kpayinda/PIM_V02/README.md

# PIM_V02
Flight-like design of PIM. After dev PIM_V01 was proven, this adds an FPGA and optimises size.
