kpayinda/PIM_V02/PIM_V02/PIM_V02_Design_Notes.docx

CHANGES FROM V01:

- I want PGOOD indicators on the payload supplies.
- MCU controls re-enable of eFuse.

eFuse updates:

eFuse: give the MCU full authority (EN + FLT + IMON), and configure latch-off

Your V01 problem is that the TPS259814A's EN/PG/FLT/IMON weren't wired to the MCU. Fix in V02:

- EN/UVLO → MCU GPIO. A high level on EN/UVLO enables the internal FET; held low, the FET is off. This is your on/off and your latch-clear: toggling EN is how the MCU resets a latched fault. Keep the UVLO divider if you want the input-undervoltage trip, and drive EN through it / OR it in — don't lose the 10.8V-ish UVLO by hard-driving the pin. Texas Instruments (https://www.ti.com/lit/ds/symlink/tps25982.pdf)
- FLT → MCU input (EXTI). FLT is an open-drain, active-low fault indicator pulled low when a fault is detected — needs a pull-up, gives you an interrupt on trip. Texas Instruments (https://www.ti.com/lit/ds/symlink/tps25981.pdf)
- PG → MCU input. PG is open-drain, asserted high when the FET is fully on and ready to deliver power. Texas Instruments (https://www.ti.com/lit/ds/symlink/tps25981.pdf)
- IMON → MCU ADC. IMON sources an analog current proportional to FET current; a resistor to GND converts it to a voltage for an ADC, with chopper offset cancellation for accuracy at low currents. Size RIMON so full-scale lands inside your ADC range with headroom. This is what turns "is it tripped" into real current telemetry. Texas Instruments (https://www.ti.com/lit/ds/symlink/tps25980.pdf)
- Configure latch-off, not auto-retry. The rule of thumb is auto-retry for consumer gear, latch-off with PG/FAULT reporting for critical loads — you want the fault to stay off until the MCU decides, so a latched-up payload can't drag the retry loop. This is also exactly your SEL power-cycle mechanism from the radiation framework: IMON→ADC detects the latchup current signature, MCU drops EN, waits, re-asserts. Close that loop deliberately. Ersa Electronics (https://www.ersaelectronics.com/blog/efuse-power-switch-ic)

FPGA:
protocol engine format.

Protocol engine: soft I2C/SPI/UART cores live in the FPGA; MCU commands it over one link ("talk I2C addr 0x40, write these bytes"). More HDL and verification, but arbitrary channel count and offloads the MCU

I2C is open-drain + pull-ups; UART/SPI are push-pull. Leave modest pull-ups (say 4.7–10k) on the muxed lines permanently — a push-pull driver fighting a pull-up just burns a little static current when low, harmless. Don't try to switch pull-ups in/out unless a payload's I2C timing demands a specific value.

I/O bank voltage. iCE40 banks are LVCMOS up to 3.3V (confirm for your exact device — UltraPlus is more restricted). If any payload wants 1.8V, plan level translation or dedicate a bank; you can't retune VCCIO per-pin.

Payload-fault isolation. These pins leave the board to experimental payloads. Series R + TVS on every payload line, and treat a payload short/latch as expected: the FPGA shouldn't be your only protection. Ideally the FPGA (and its I/O bank) sits behind its own monitored/switchable rail so a payload event can be power-cycled without rebooting the whole PIM.

SRAM config in orbit. iCE40 is SRAM-based — it reloads its bitstream every power cycle (MCU over SPI1, per your V01 plan) and its config SRAM can flip under SEU. At ~5 krad TID the dose is likely survivable, but plan config scrubbing: periodic MCU reconfiguration, or CRAM readback-compare, or warmboot on mismatch. Bake this into firmware from the start, not as a retrofit.

MY QUESTIONS:

Inductor placement. moving the inductor to the top side was only meant to help layout better. but if its actually detrimental to this, that sounds like a horrible idea. currently my setup is really good with all power on bottom, as it allows me to put the HK 3v3 and 5v rails underneath where the rest of the circuit on the topside needs them, then all the payload supplies on the far side out of the way. if i had to move all the ICs and caps related to power to the top too, i definitley cannot fit it all. is there a way i can get really flat inductors? its fine if the footprint is bigger, i just need them to have less height.

Also separate issue, in my opinion the power section takes up a lot of room. is there a way i can get the housekeeping supplies to be all merged? i definitley need a stable 5v, 3v3 and 1v2, but it annoys me that i need such a large section for each, especially since they are low power. any solutions? is there a controller than can do all in 1?

I also want advice how to layout the schematic. you have the current layout, with a 'main', CAN and POWER page. but is this the best way? especialy since the 'main' page is full of a jumble of different sections. also with fpga i would need to make a new page to be able to fit more. how do professionals organise their scheamtics? i also dont want too many sheets as that is unnecessarily hard to track then.

## Power Circuit

Inductor selection, updates to not protrude as much.

Aiming for 1.5mm height.

- Replaced all Ls w SRP5015TA-2R2M.
- Fit 0R on all RT (inc freq).

23-SEP-26. KP.

Adding INA current sense to monitor output of PL supplies.

Shunt selection. 10mR 2512

NO NEW PINS – USING SAME I2C PINS AS BEFORE.

Addy: A0 → GND for address 0x40 versus MP28167 is at 0x60. So algs.

\

Changed SWD connector to just pads – so can flash thru SWD but not easy.
