kpayinda/PIM_V02/PIM_V02/PIM_V02.kicad_pcb

## KiCad design PIM_V02/PIM_V02.kicad_pcb (2026-09-28)

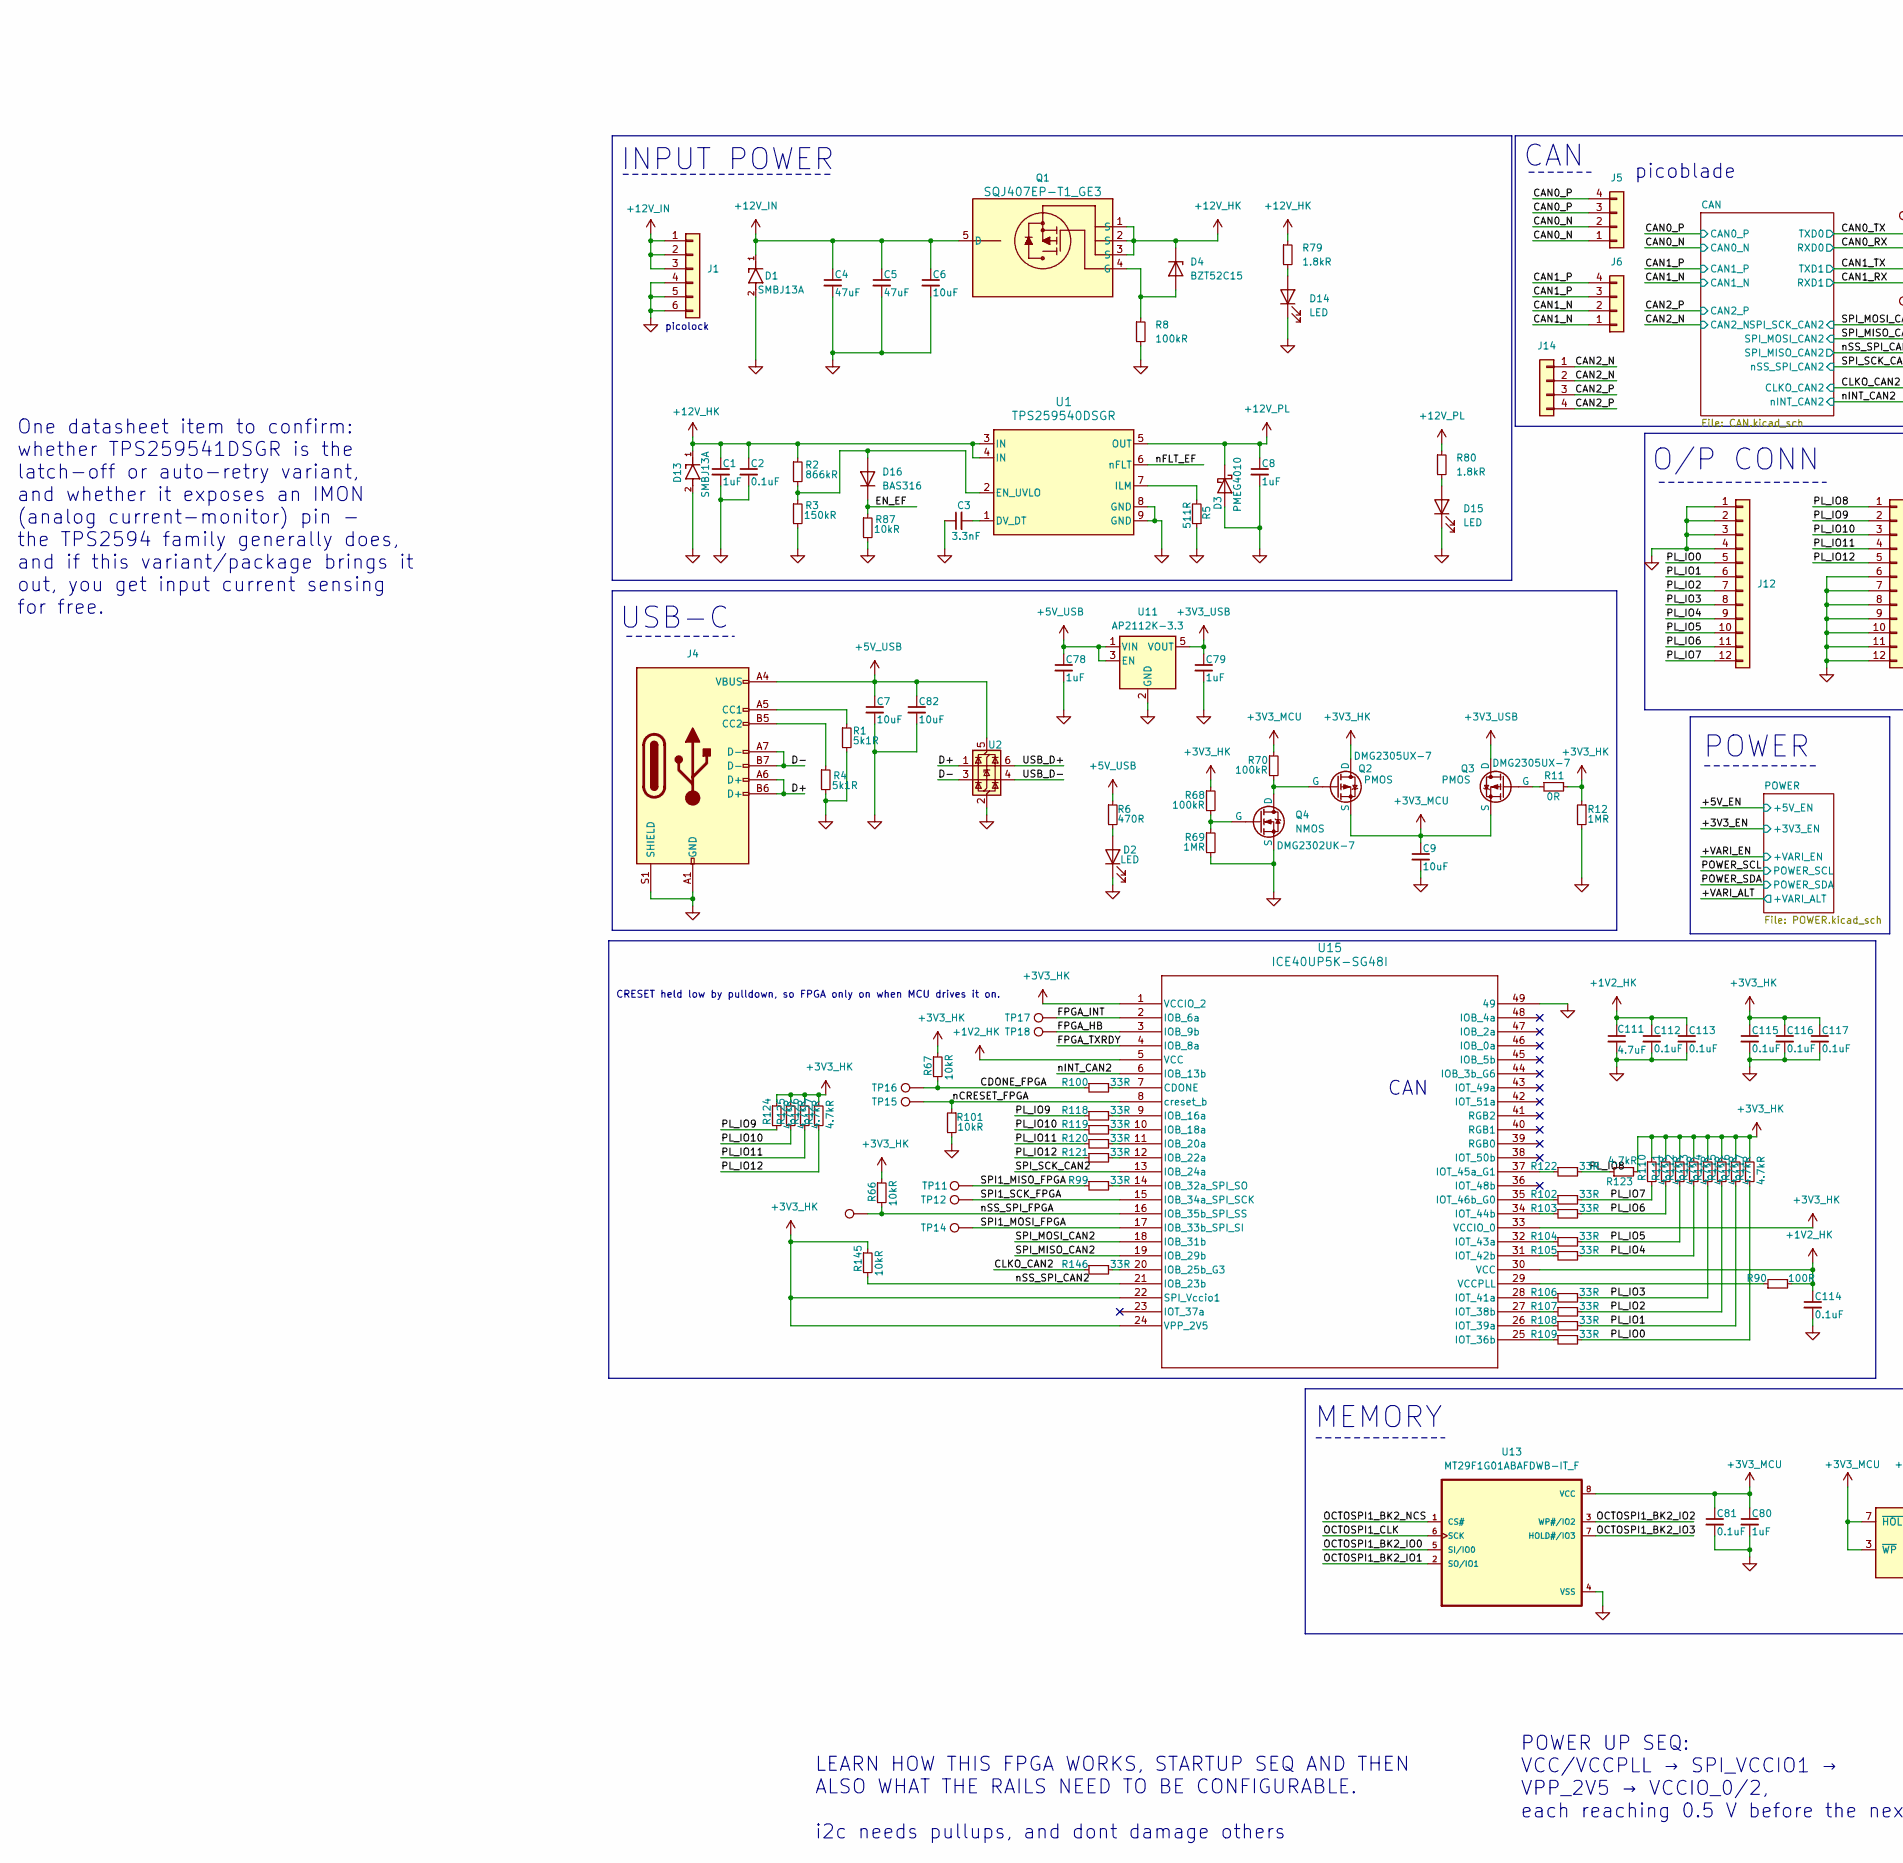
[picture p1: schematic PIM_V02.kicad_sch, PCI-104 Template, part in row 1, column 1]

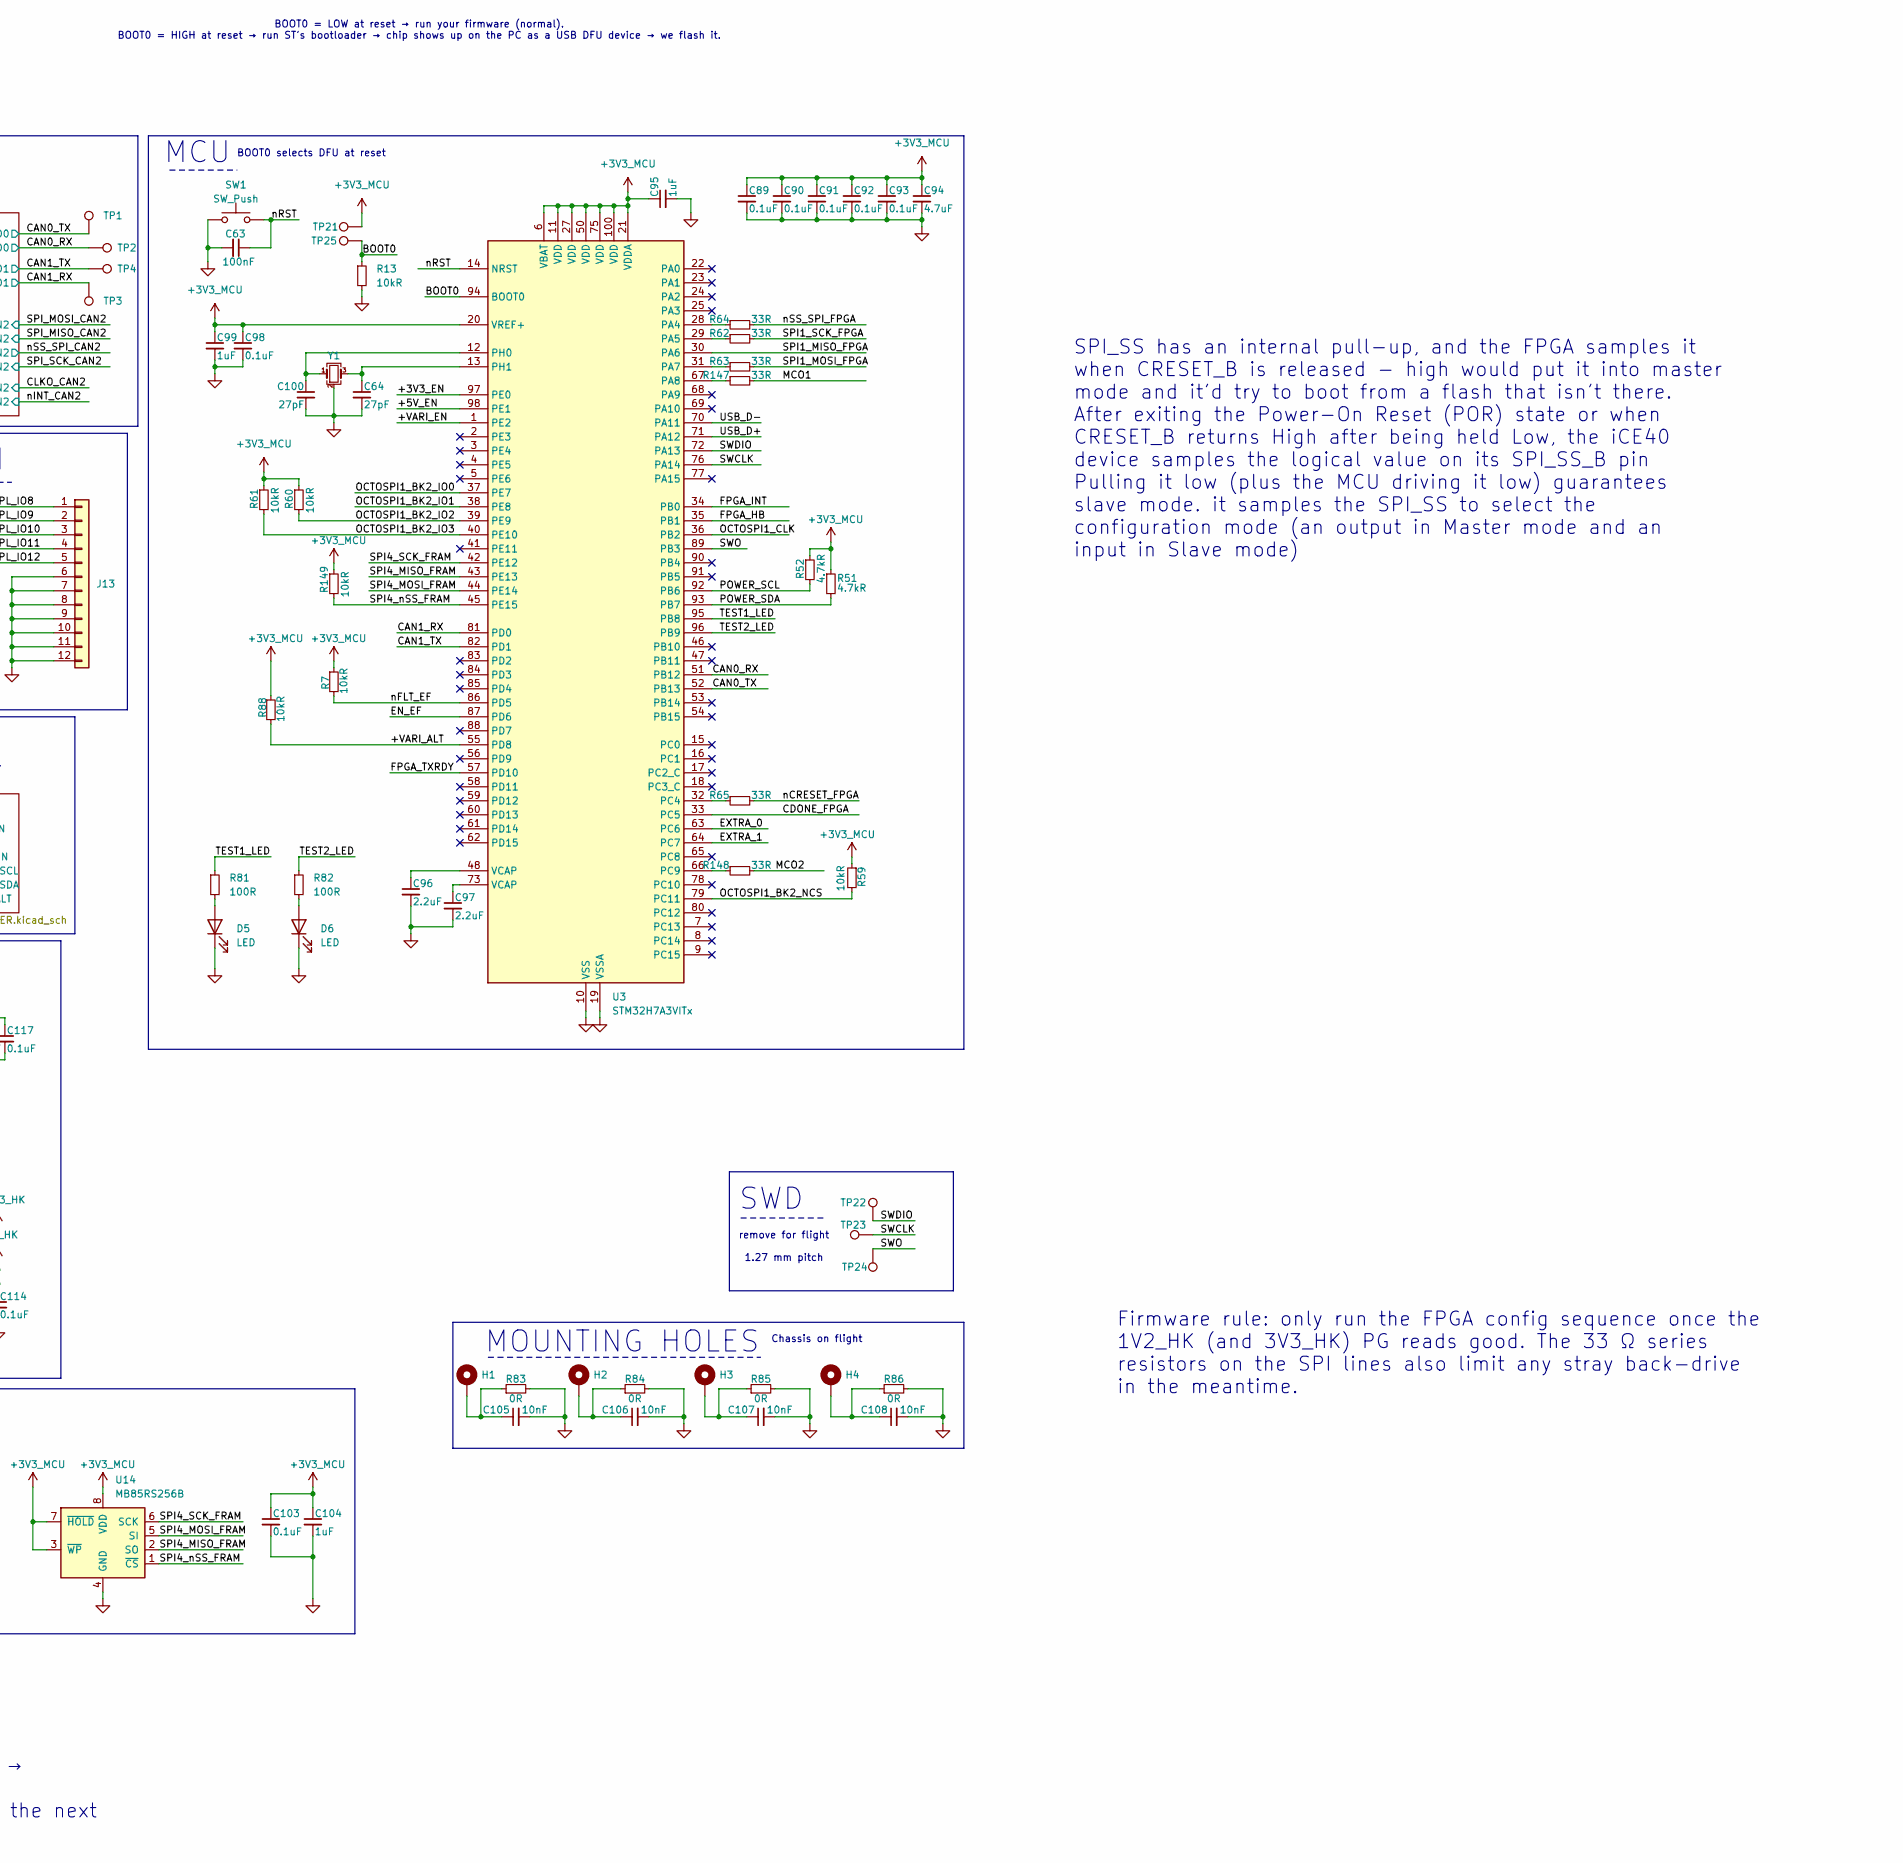
[picture p2: schematic PIM_V02.kicad_sch, PCI-104 Template, part in row 1, column 2]

Parts:
C1, C8, C78, C79, C80, C95, C99, C104: 1uF; C_0603_1608Metric; MPN GCM188R71E105KA64J
C2, C81, C89, C90, C91, C92, C93, C98, C103, C112, C113, C114, C115, C116, C117: 0.1uF; C_0603_1608Metric; MPN GCM188R71H104KA57D
C3: 3.3nF; C_0603_1608Metric; MPN GCM1885C1H332JA16D
C4, C5: 47uF; C_1206_3216Metric; Rating 50V, MLCC; MPN GMC31X5R476M25NT
C6, C7, C9, C82: 10uF; C_0603_1608Metric; MPN GRT188R61E106ME13D
C63: 100nF; C_0603_1608Metric; MPN GCM188R71H104KA57D
C64, C100: 27pF; C_0603_1608Metric; MPN GCM1885C1H270JA16D
C94, C111: 4.7uF; C_0603_1608Metric; MPN MSAST168BB5475MTNA01
C96, C97: 2.2uF; C_0603_1608Metric; MPN GRT188R61E225ME13D
C105, C106, C107, C108: 10nF; C_0603_1608Metric; MPN GCM188R71H103KA37J
D1, D13: SMBJ13A
D2, D5, D6, D14, D15: LED; LED_0603_1608Metric; MPN 150060GS75000
D3: PMEG4010; Nexperia_CFP3_SOD-123W; MPN PMEG4010ER,115
D4: BZT52C15; Nexperia_CFP3_SOD-123W; MPN BZT52C15
D16: BAS316; D_SOD-323
H1, H2, H3, H4: MountingHole_Pad; MountingHole_2.2mm_M2_Pad
J1: Conn_01x06; Molex_Pico-Lock_504050-0691_1x06-1MP_P1.50mm_Horizontal; MPN 5040500691
J4: USB_C_Receptacle_USB2.0_14P; USB_C_Receptacle_GCT_USB4105-xx-A_16P_TopMnt_Horizontal; MPN USB4105-GF-A
J5, J6, J14: Conn_01x04; Molex_PicoBlade_53261-0471_1x04-1MP_P1.25mm_Horizontal; MPN 0532610471
J12, J13: Conn_01x12; 5040501291
Q1: SQJ407EP-T1_GE3; PowerPAK-SO-8L_Option-2_VIS; MPN SQJ407EP-T1_GE3
Q2, Q3: PMOS; SOT-23-3; MPN DMG2305UX-7
Q4: NMOS; SOT-23-3; MPN DMG2302UK-7
R1, R4: 5k1R; R_0603_1608Metric; MPN ERJ-3EKF5101V
R2: 866kR; R_0603_1608Metric; MPN ERJ-3EKF8663V
R3: 150kR; R_0603_1608Metric; MPN ERJ-3EKF1503V
R5: 511R; R_0603_1608Metric; MPN ERJ-3EKF5110V
R6: 470R; R_0603_1608Metric; MPN ERJ-3EKF4700V
R7, R13, R59, R60, R61, R66, R67, R88, R145, R149: 10kR; R_0603_1608Metric; MPN ERJ-3EKF1002V
R8, R68, R70: 100kR; R_0603_1608Metric; MPN ERJ-3EKF1003V
R11, R83, R84, R85, R86: 0R; R_0603_1608Metric; MPN ERJ-3GEY0R00V
R12, R69: 1MR; R_0603_1608Metric; MPN ERJ-3EKF1004V
R51, R52: 4.7kR; R_0603_1608Metric; MPN ERJ-3EKF4701V
R62, R63, R64, R65, R122, R147, R148: 33R; R_0603_1608Metric; MPN ERJ-3EKF33R0V
R79, R80: 1.8kR; R_0603_1608Metric; MPN ERJ-3EKF1801V
R81, R82, R90: 100R; R_0603_1608Metric; MPN ERJ-3EKF1000V
R87, R101: 10kR; R_0603_1608Metric
R99, R100, R102, R103, R104, R105, R106, R107, R108, R109, R118, R119, R120, R121, R146: 33R; R_0402_1005Metric; MPN ERJ-2RKF33R0X
R110, R111, R112, R113, R114, R115, R116, R117, R123, R124, R125, R126, R127: 4.7kR; R_0402_1005Metric; MPN ERJ-2RKF4701X
SW1: SW_Push; SW_SPST_B3U-1000P; MPN B3U-1000P
TP1, TP2, TP3, TP4, TP11, TP12, TP13, TP14, TP15, TP16, TP17, TP18, TP21, TP22, TP23, TP24, TP25: TestPoint; TestPoint_Pad_D1.0mm
U1: TPS259540DSGR; DSG0008A; MPN TPS259540DSGR
U2: USBLC6-2SC6; SOT-23-6; MPN USBLC6-2SC6
U3: STM32H7A3VITx; LQFP-100_14x14mm_P0.5mm; MPN STM32H7A3VIT6
U11: AP2112K-3.3; SOT-23-5; MPN AP2112K-3.3TRG1
U13: MT29F1G01ABAFDWB-IT_F; GD5F1GQ5UEYIGR; PARTREV LTR
U14: MB85RS256B; JEITA_SOIC-8_3.9x4.9mm_P1.27mm; MPN MB85RS256BPNF-G-AMERE2
U15: ICE40UP5K-SG48I; QFN48_L-ASC10_ICE40ULTRAPLUS_MACHXO2_LAT
Y1: Crystal_GND24_Small; Crystal_SMD_Abracon_ABM8G-4Pin_3.2x2.5mm; MPN ABM8G-24.000MHZ-18-D2Y-T3

Connections:
+1V2_HK: C111.1, C112.1, C113.1, C114.1, R90.2, U15.5 (VCC), U15.30 (VCC); also elsewhere on the board
+3V3_HK: C115.1, C116.1, C117.1, Q2.1 (D), R11.2, R12.1, R66.1, R67.1, R68.1, R110.1, R111.1, R112.1, R113.1, R114.1, R115.1, R116.1, R117.1, R123.2, R124.1, R125.1, R126.1, R127.1, R145.1, U15.1 (VCCIO_2), U15.22 (SPI_Vccio1), U15.24 (VPP_2V5), U15.33 (VCCIO_0); also elsewhere on the board
+3V3_MCU: C9.1, C80.1, C81.1, C89.1, C90.1, C91.1, C92.1, C93.1, C94.1, C95.1, C98.1, C99.1, C103.1, C104.1, Q2.3 (S), Q3.3 (S), R7.1, R51.1, R52.1, R59.1, R60.1, R61.1, R70.1, R88.1, R149.1, TP21.1, U3.6 (VBAT), U3.11 (VDD), U3.20 (VREF+), U3.21 (VDDA), U3.27 (VDD), U3.50 (VDD), U3.75 (VDD), U3.100 (VDD), U13.8 (VCC), U14.3 (~WP), U14.7 (~HOLD), U14.8 (VDD); also elsewhere on the board
+3V3_USB: C79.1, Q3.1 (D), U11.5 (VOUT)
+5V_USB: C7.1, C78.1, C82.1, J4.A4 (VBUS), J4.A9 (VBUS), J4.B4 (VBUS), J4.B9 (VBUS), R6.1, U2.5 (VBUS), U11.1 (VIN), U11.3 (EN)
+12V_HK: C1.1, C2.1, D4.1 (K), D13.1, Q1.1 (S), Q1.2 (S), Q1.3 (S), R2.1, R79.1, U1.3 (IN), U1.4 (IN); also elsewhere on the board
+12V_IN: C4.1, C5.1, C6.1, D1.1, J1.1, J1.2, J1.3, Q1.5 (D)
+12V_PL: C8.1, D3.1 (K), R80.1, U1.5 (OUT); also elsewhere on the board
/+3V3_EN: U3.97 (PE0); also elsewhere on the board
/+5V_EN: U3.98 (PE1); also elsewhere on the board
/+VARI_ALT: R88.2, U3.55 (PD8); also elsewhere on the board
/+VARI_EN: U3.1 (PE2); also elsewhere on the board
/BOOT0: R13.1, TP25.1, U3.94 (BOOT0)
/CAN0_N: J5.1, J5.2; also elsewhere on the board
/CAN0_P: J5.3, J5.4; also elsewhere on the board
/CAN0_RX: TP2.1, U3.51 (PB12); also elsewhere on the board
/CAN0_TX: TP1.1, U3.52 (PB13); also elsewhere on the board
/CAN1_N: J6.1, J6.2; also elsewhere on the board
/CAN1_P: J6.3, J6.4; also elsewhere on the board
/CAN1_RX: TP3.1, U3.81 (PD0); also elsewhere on the board
/CAN1_TX: TP4.1, U3.82 (PD1); also elsewhere on the board
/CAN2_N: J14.1, J14.2; also elsewhere on the board
/CAN2_P: J14.3, J14.4; also elsewhere on the board
/CDONE_FPGA: R67.2, R100.1, TP16.1, U3.33 (PC5)
/CLKO_CAN2: R146.1; also elsewhere on the board
/D+: J4.A6 (D+), J4.B6 (D+), U2.1 (I/O1)
/D-: J4.A7 (D-), J4.B7 (D-), U2.3 (I/O2)
/EN_EF: D16.1 (K), R87.1, U3.87 (PD6)
/EXTRA_0: U3.63 (PC6)
/EXTRA_1: U3.64 (PC7)
/FPGA_HB: TP18.1, U3.35 (PB1), U15.3 (IOB_9b)
/FPGA_INT: TP17.1, U3.34 (PB0), U15.2 (IOB_6a)
/FPGA_TXRDY: U3.57 (PD10), U15.4 (IOB_8a)
/MCO1: R147.2
/MCO2: R148.2
/OCTOSPI1_BK2_IO0: U3.37 (PE7), U13.5 (SI/IO0)
/OCTOSPI1_BK2_IO1: U3.38 (PE8), U13.2 (SO/IO1)
/OCTOSPI1_BK2_IO2: R60.2, U3.39 (PE9), U13.3 (WP#/IO2)
/OCTOSPI1_BK2_IO3: R61.2, U3.40 (PE10), U13.7 (HOLD#/IO3)
/OCTOSPI1_BK2_NCS: R59.2, U3.79 (PC11), U13.1 (CS#)
/OCTOSPI1_CLK: U3.36 (PB2), U13.6 (SCK)
/PL_IO0: J12.5, R109.2, R117.2
/PL_IO1: J12.6, R108.2, R116.2
/PL_IO2: J12.7, R107.2, R115.2
/PL_IO3: J12.8, R106.2, R114.2
/PL_IO4: J12.9, R105.2, R113.2
/PL_IO5: J12.10, R104.2, R112.2
/PL_IO6: J12.11, R103.2, R111.2
/PL_IO7: J12.12, R102.2, R110.2
/PL_IO8: J13.1, R122.2, R123.1
/PL_IO9: J13.2, R118.1, R124.2
/PL_IO10: J13.3, R119.1, R125.2
/PL_IO11: J13.4, R120.1, R126.2
/PL_IO12: J13.5, R121.1, R127.2
/POWER_SCL: R52.2, U3.92 (PB6); also elsewhere on the board
/POWER_SDA: R51.2, U3.93 (PB7); also elsewhere on the board
/SPI1_MISO_FPGA: R99.1, TP11.1, U3.30 (PA6)
/SPI1_MOSI_FPGA: R63.2, TP14.1, U15.17 (IOB_33b_SPI_SI)
/SPI1_SCK_FPGA: R62.2, TP12.1, U15.15 (IOB_34a_SPI_SCK)
/SPI4_MISO_FRAM: U3.43 (PE13), U14.2 (SO)
/SPI4_MOSI_FRAM: U3.44 (PE14), U14.5 (SI)
/SPI4_SCK_FRAM: U3.42 (PE12), U14.6 (SCK)
/SPI4_nSS_FRAM: R149.2, U3.45 (PE15), U14.1 (~CS)
/SPI_MISO_CAN2: U15.19 (IOB_29b); also elsewhere on the board
/SPI_MOSI_CAN2: U15.18 (IOB_31b); also elsewhere on the board
/SPI_SCK_CAN2: U15.13 (IOB_24a); also elsewhere on the board
/SWCLK: TP23.1, U3.76 (PA14)
/SWDIO: TP22.1, U3.72 (PA13)
/SWO: TP24.1, U3.89 (PB3)
/TEST1_LED: R81.1, U3.95 (PB8)
/TEST2_LED: R82.1, U3.96 (PB9)
/USB_D+: U2.6 (I/O1), U3.71 (PA12)
/USB_D-: U2.4 (I/O2), U3.70 (PA11)
/nCRESET_FPGA: R65.2, R101.1, TP15.1, U15.8 (creset_b)
/nFLT_EF: R7.2, U1.6 (nFLT), U3.86 (PD5)
/nINT_CAN2: U15.6 (IOB_13b); also elsewhere on the board
/nRST: C63.1, SW1.2, U3.14 (NRST)
/nSS_SPI_CAN2: R145.2, U15.21 (IOB_23b); also elsewhere on the board
/nSS_SPI_FPGA: R64.2, R66.2, TP13.1, U15.16 (IOB_35b_SPI_SS)
GND: C1.2, C2.2, C3.1, C4.2, C5.2, C6.2, C7.2, C8.2, C9.2, C63.2, C64.2, C78.2, C79.2, C80.2, C81.2, C82.2, C89.2, C90.2, C91.2, C92.2, C93.2, C94.2, C95.2, C96.2, C97.2, C98.2, C99.2, C100.2, C103.2, C104.2, C105.2, C106.2, C107.2, C108.2, C111.2, C112.2, C113.2, C114.2, C115.2, C116.2, C117.2, D1.2, D2.1 (K), D3.2 (A), D5.1 (K), D6.1 (K), D13.2, D14.1 (K), D15.1 (K), J1.4, J1.5, J1.6, J4.A1 (GND), J4.A12 (GND), J4.B1 (GND), J4.B12 (GND), J4.S1 (SHIELD), J12.1, J12.2, J12.3, J12.4, J13.6, J13.7, J13.8, J13.9, J13.10, J13.11, J13.12, Q4.3 (S), R1.2, R3.2, R4.2, R5.1, R8.2, R12.2, R13.2, R69.2, R83.2, R84.2, R85.2, R86.2, R87.2, R101.2, SW1.1, U1.8 (GND), U1.9 (GND), U2.2 (GND), U3.10 (VSS), U3.19 (VSSA), U3.26 (VSS), U3.49 (VSS), U3.74 (VSS), U3.99 (VSS), U11.2 (GND), U13.4 (VSS), U14.4 (GND), U15.49, Y1.2 (G), Y1.4 (G); also elsewhere on the board
unnamed: C96.1, U3.48 (VCAP)
unnamed: C97.1, U3.73 (VCAP)
unnamed: C105.1, H1.1, R83.1
unnamed: C106.1, H2.1, R84.1
unnamed: C107.1, H3.1, R85.1
unnamed: C108.1, H4.1, R86.1
unnamed: D2.2 (A), R6.2
unnamed: D4.2 (A), Q1.4 (G), R8.1
unnamed: D5.2 (A), R81.2
unnamed: D6.2 (A), R82.2
unnamed: D14.2 (A), R79.2
unnamed: D15.2 (A), R80.2
unnamed: D16.2 (A), R2.2, R3.1, U1.2 (EN_UVLO)
unnamed: J4.A5 (CC1), R1.1
unnamed: J4.B5 (CC2), R4.1
unnamed: Q2.2 (G), Q4.1 (D), R70.2
unnamed: Q3.2 (G), R11.1
unnamed: Q4.2 (G), R68.2, R69.1
unnamed: C3.2, U1.1 (DV_DT)
unnamed: R5.2, U1.7 (ILM)
unnamed: R64.1, U3.28 (PA4)
unnamed: R62.1, U3.29 (PA5)
unnamed: R63.1, U3.31 (PA7)
unnamed: R147.1, U3.67 (PA8)
unnamed: R65.1, U3.32 (PC4)
unnamed: R148.1, U3.66 (PC9)
unnamed: C100.1, U3.12 (PH0), Y1.1
unnamed: C64.1, U3.13 (PH1), Y1.3
unnamed: R100.2, U15.7 (CDONE)
unnamed: R118.2, U15.9 (IOB_16a)
unnamed: R119.2, U15.10 (IOB_18a)
unnamed: R120.2, U15.11 (IOB_20a)
unnamed: R121.2, U15.12 (IOB_22a)
unnamed: R146.2, U15.20 (IOB_25b_G3)
unnamed: R99.2, U15.14 (IOB_32a_SPI_SO)
unnamed: R109.1, U15.25 (IOT_36b)
unnamed: R107.1, U15.27 (IOT_38b)
unnamed: R108.1, U15.26 (IOT_39a)
unnamed: R106.1, U15.28 (IOT_41a)
unnamed: R105.1, U15.31 (IOT_42b)
unnamed: R104.1, U15.32 (IOT_43a)
unnamed: R103.1, U15.34 (IOT_44b)
unnamed: R122.1, U15.37 (IOT_45a_G1)
unnamed: R102.1, U15.35 (IOT_46b_G0)
unnamed: R90.1, U15.29 (VCCPLL)

Notes on the sheet:
BOOT0 selects DFU at reset
LEARN HOW THIS FPGA WORKS, STARTUP SEQ AND THEN ALSO WHAT THE RAILS NEED TO BE CONFIGURABLE. i2c needs pullups, and dont damage others
picoblade
POWER UP SEQ: VCC/VCCPLL → SPI_VCCIO1 → VPP_2V5 → VCCIO_0/2, each reaching 0.5 V before the next
BOOT0 = LOW at reset → run your firmware (normal). BOOT0 = HIGH at reset → run ST's bootloader → chip shows up on the PC as a USB DFU device → we flash it.
remove for flight 1.27 mm pitch
SPI_SS has an internal pull-up, and the FPGA samples it when CRESET_B is released - high would put it into master mode and it'd try to boot from a flash that isn't there. After exiting the Power-On Reset (POR) state or when CRESET_B returns High after being held Low, the iCE40 device samples the lo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
CRESET held low by pulldown, so FPGA only on when MCU drives it on.
USB-C
Chassis on flight
POWER
MCU
One datasheet item to confirm: whether TPS259541DSGR is the latch-off or auto-retry variant, and whether it exposes an IMON (analog current-monitor) pin - the TPS2594 family generally does, and if this variant/package brings it out, you get input current sensing for free.
picolock
O/P CONN
Firmware rule: only run the FPGA config sequence once the 1V2_HK (and 3V3_HK) PG reads good. The 33 Ω series resistors on the SPI lines also limit any stray back-drive in the meantime.
INPUT POWER
CAN
MEMORY
MOUNTING HOLES
SWD

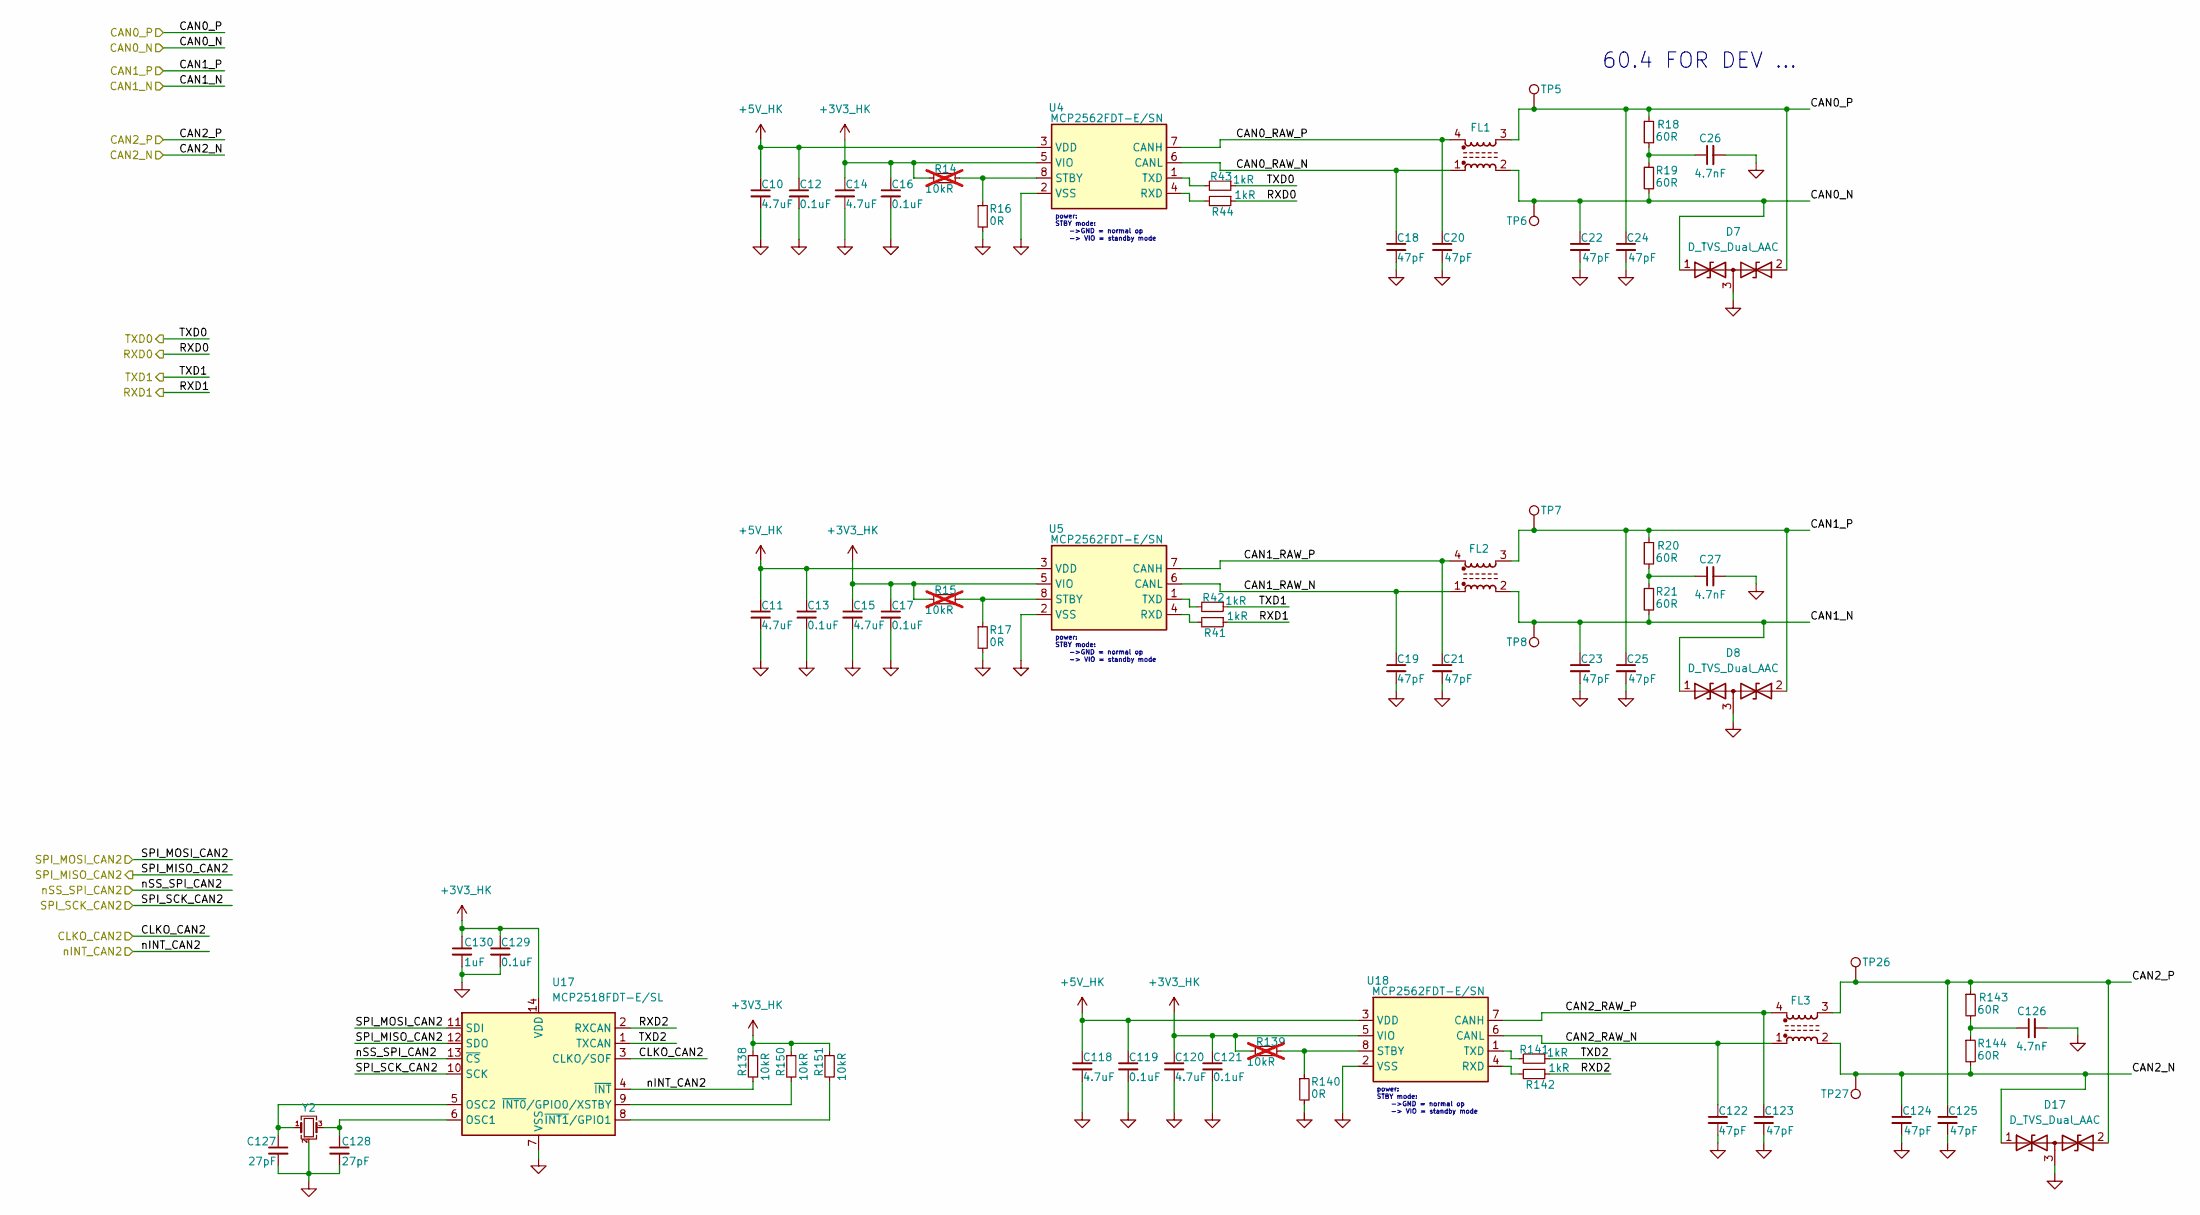
[picture p3: schematic CAN.kicad_sch]

Parts:
C10, C11, C14, C15, C118, C120: 4.7uF; C_0603_1608Metric; MPN MSAST168BB5475MTNA01
C12, C13, C16, C17, C119, C121, C129: 0.1uF; C_0603_1608Metric; MPN GCM188R71H104KA57D
C18, C19, C20, C21, C22, C23, C24, C25, C122, C123, C124, C125: 47pF; C_0603_1608Metric; MPN GCM1885C1H470JA16D
C26, C27, C126: 4.7nF; C_0603_1608Metric; MPN GCM1885C1H472GA16D
C127, C128: 27pF; C_0603_1608Metric; MPN GCM1885C1H270JA16D
C130: 1uF; C_0603_1608Metric; MPN GCM188R71E105KA64J
D7, D8, D17: D_TVS_Dual_AAC; SOT-23-3; MPN ESD16VHYFHT116
FL1, FL2, FL3: Choke_CommonMode_FerriteCore_1243; L_CommonModeChoke_Coilcraft_1812CAN; MPN ACT45B-101-2P-TL003
R14, R15, R139: 10kR; R_0603_1608Metric; MPN ERJ-3EKF1002V; not fitted
R16, R17, R140: 0R; R_0603_1608Metric; MPN ERJ-3GEY0R00V
R18, R19, R20, R21, R143, R144: 60R; R_0603_1608Metric; MPN ERJ-3EKF60R4V
R41, R42, R43, R44, R141, R142: 1kR; R_0603_1608Metric; MPN ERJ-3EKF1001V
R138, R150, R151: 10kR; R_0603_1608Metric; MPN ERJ-3EKF1002V
TP5, TP6, TP7, TP8, TP26, TP27: TestPoint; TestPoint_Pad_D1.0mm
U4, U5, U18: MCP2562FDT-E/SN; SOIC-8_3.9x4.9mm_P1.27mm; MPN MCP2562FDT-E/SN
U17: MCP2518FDT-E/SL; SOIC-14_3.9x8.7mm_P1.27mm
Y2: Crystal_GND24_Small; Crystal_SMD_Abracon_ABM8G-4Pin_3.2x2.5mm; MPN ABM8G-40.000MHZ-18-D2Y-T

Connections:
+3V3_HK: C14.1, C15.1, C16.1, C17.1, C120.1, C121.1, C129.1, C130.1, R14.2, R15.2, R138.1, R139.2, R150.1, R151.1, U4.5 (VIO), U5.5 (VIO), U17.14 (VDD), U18.5 (VIO); also elsewhere on the board
+5V_HK: C10.1, C11.1, C12.1, C13.1, C118.1, C119.1, U4.3 (VDD), U5.3 (VDD), U18.3 (VDD); also elsewhere on the board
/CAN0_N: C22.1, D7.1 (A1), FL1.2, R19.2, TP6.1; also elsewhere on the board
/CAN0_P: C24.1, D7.2 (A2), FL1.3, R18.1, TP5.1; also elsewhere on the board
/CAN0_RX: R44.1; also elsewhere on the board
/CAN0_TX: R43.1; also elsewhere on the board
/CAN1_N: C23.1, D8.1 (A1), FL2.2, R21.2, TP8.1; also elsewhere on the board
/CAN1_P: C25.1, D8.2 (A2), FL2.3, R20.1, TP7.1; also elsewhere on the board
/CAN1_RX: R41.1; also elsewhere on the board
/CAN1_TX: R42.1; also elsewhere on the board
/CAN2_N: C124.1, D17.1 (A1), FL3.2, R144.2, TP27.1; also elsewhere on the board
/CAN2_P: C125.1, D17.2 (A2), FL3.3, R143.1, TP26.1; also elsewhere on the board
/CAN/CAN0_RAW_N: C18.1, FL1.1, U4.6 (CANL)
/CAN/CAN0_RAW_P: C20.1, FL1.4, U4.7 (CANH)
/CAN/CAN1_RAW_N: C19.1, FL2.1, U5.6 (CANL)
/CAN/CAN1_RAW_P: C21.1, FL2.4, U5.7 (CANH)
/CAN/CAN2_RAW_N: C122.1, FL3.1, U18.6 (CANL)
/CAN/CAN2_RAW_P: C123.1, FL3.4, U18.7 (CANH)
/CAN/RXD2: R142.1, U17.2 (RXCAN)
/CAN/TXD2: R141.1, U17.1 (TXCAN)
/CLKO_CAN2: U17.3 (CLKO/SOF); also elsewhere on the board
/SPI_MISO_CAN2: U17.11 (SDI); also elsewhere on the board
/SPI_MOSI_CAN2: U17.10 (SCK); also elsewhere on the board
/SPI_SCK_CAN2: U17.13 (~CS); also elsewhere on the board
/nINT_CAN2: R138.2, U17.4 (~INT); also elsewhere on the board
/nSS_SPI_CAN2: U17.12 (SDO); also elsewhere on the board
GND: C10.2, C11.2, C12.2, C13.2, C14.2, C15.2, C16.2, C17.2, C18.2, C19.2, C20.2, C21.2, C22.2, C23.2, C24.2, C25.2, C26.2, C27.2, C118.2, C119.2, C120.2, C121.2, C122.2, C123.2, C124.2, C125.2, C126.2, C127.2, C128.2, C129.2, C130.2, D7.3 (common), D8.3 (common), D17.3 (common), R16.2, R17.2, R140.2, U4.2 (VSS), U5.2 (VSS), U17.7 (VSS), U17.15 (VSS), U18.2 (VSS), Y2.2 (G), Y2.4 (G); also elsewhere on the board
unnamed: C26.1, R18.2, R19.1
unnamed: C27.1, R20.2, R21.1
unnamed: C126.1, R143.2, R144.1
unnamed: R44.2, U4.4 (RXD)
unnamed: R14.1, R16.1, U4.8 (STBY)
unnamed: R43.2, U4.1 (TXD)
unnamed: R41.2, U5.4 (RXD)
unnamed: R15.1, R17.1, U5.8 (STBY)
unnamed: R42.2, U5.1 (TXD)
unnamed: C128.1, U17.6 (OSC1), Y2.3
unnamed: C127.1, U17.5 (OSC2), Y2.1
unnamed: R150.2, U17.9 (~INT0/GPIO0/XSTBY)
unnamed: R151.2, U17.8 (~INT1/GPIO1)
unnamed: R142.2, U18.4 (RXD)
unnamed: R139.1, R140.1, U18.8 (STBY)
unnamed: R141.2, U18.1 (TXD)

Notes on the sheet:
60.4 FOR DEV ...
power: STBY mode: ->GND = normal op -> VIO = standby mode
