kpayinda/PIM_V02/PIM_V02/PIM_V02.kicad_pcb

## KiCad design PIM_V02/PIM_V02.kicad_pcb (continued)

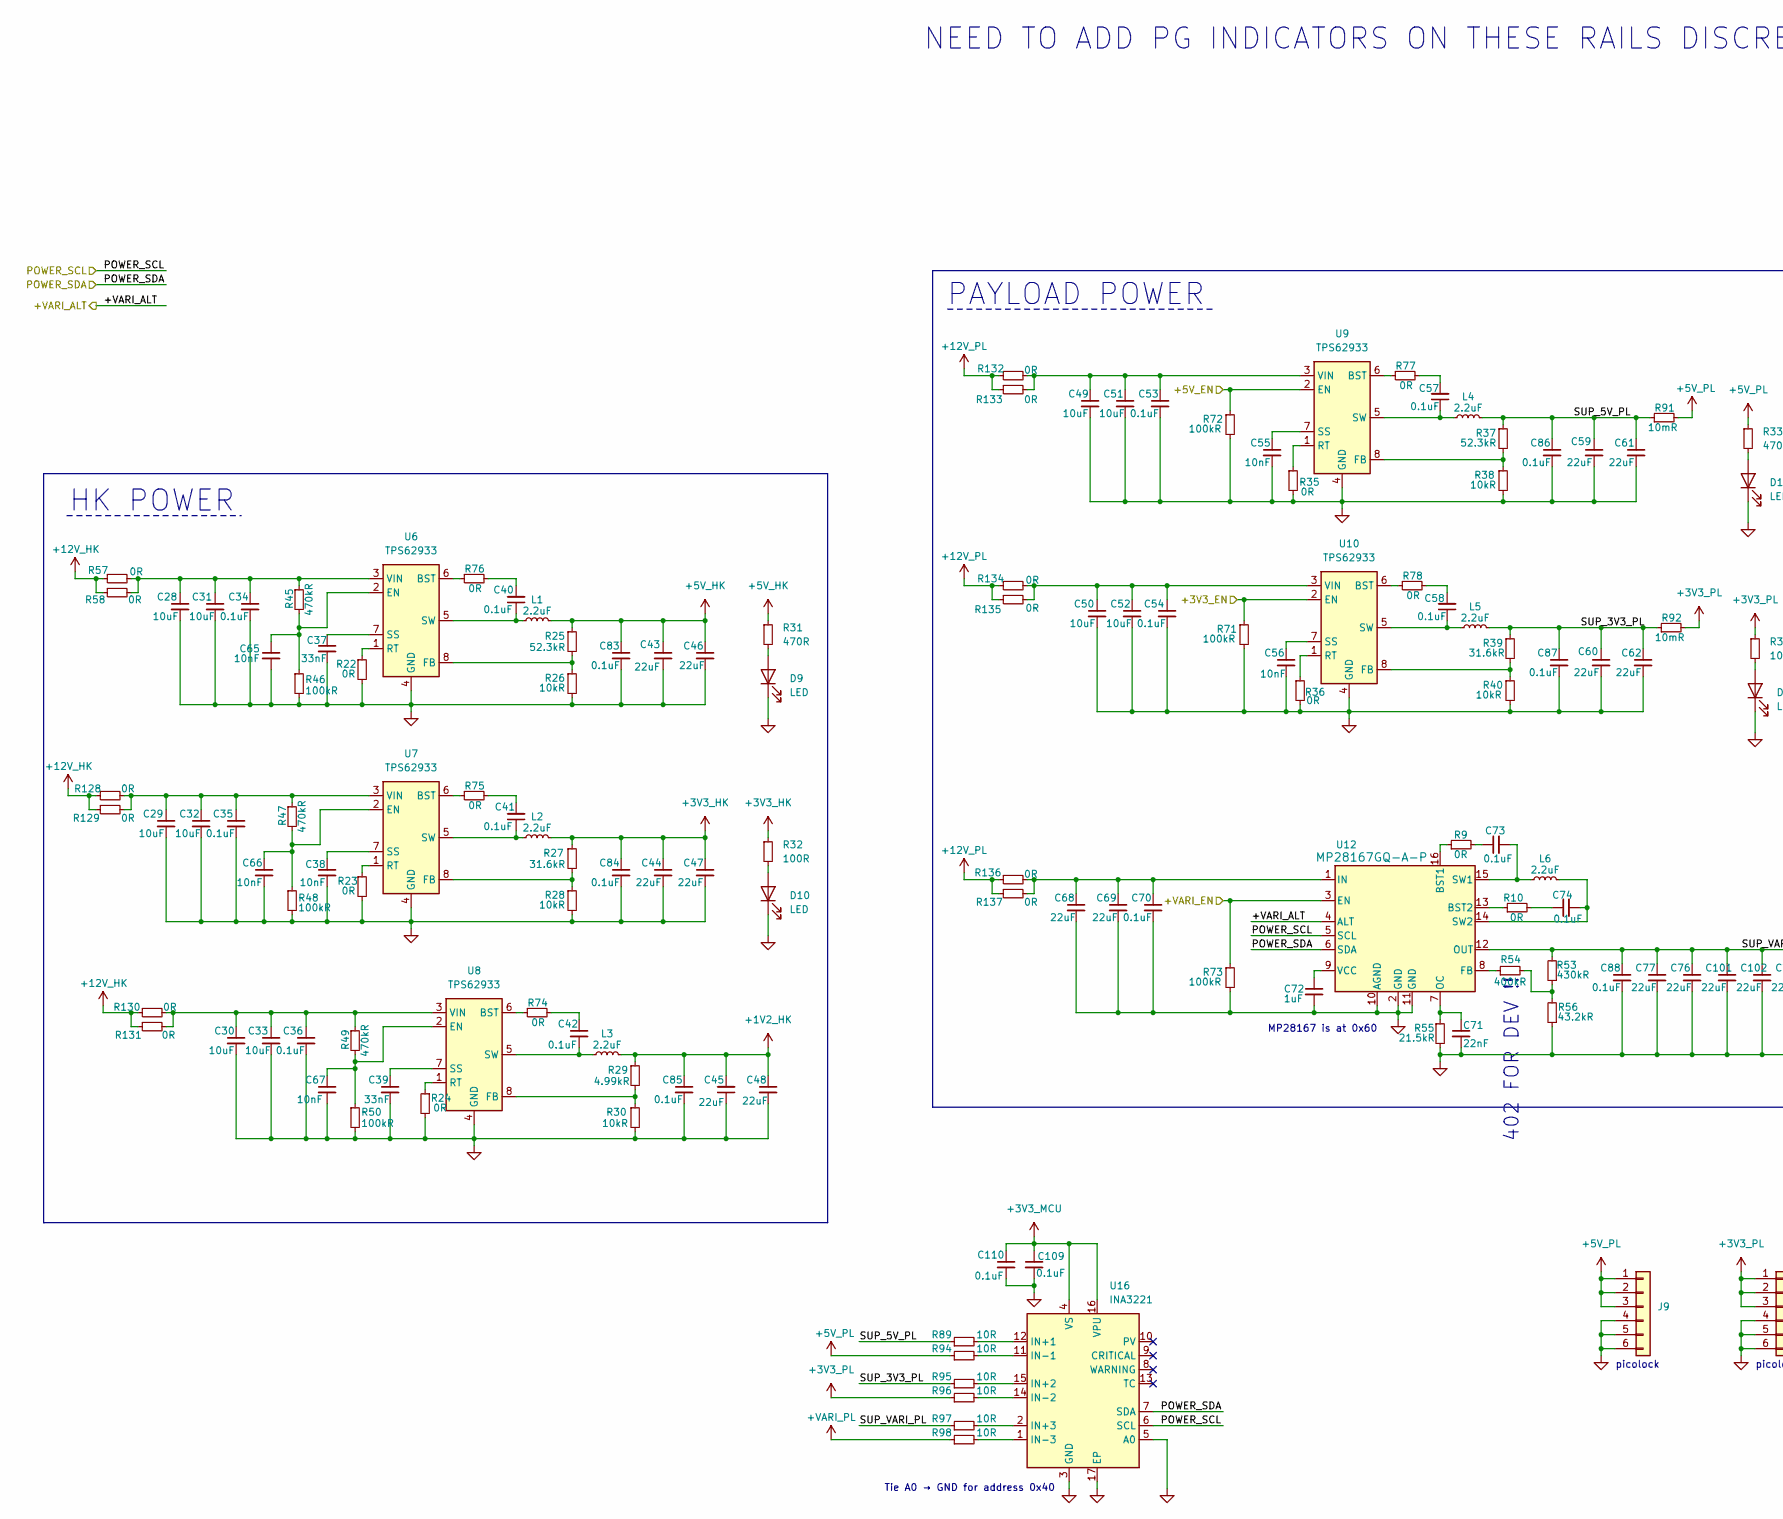
[picture p4: schematic POWER.kicad_sch, part in row 1, column 1]

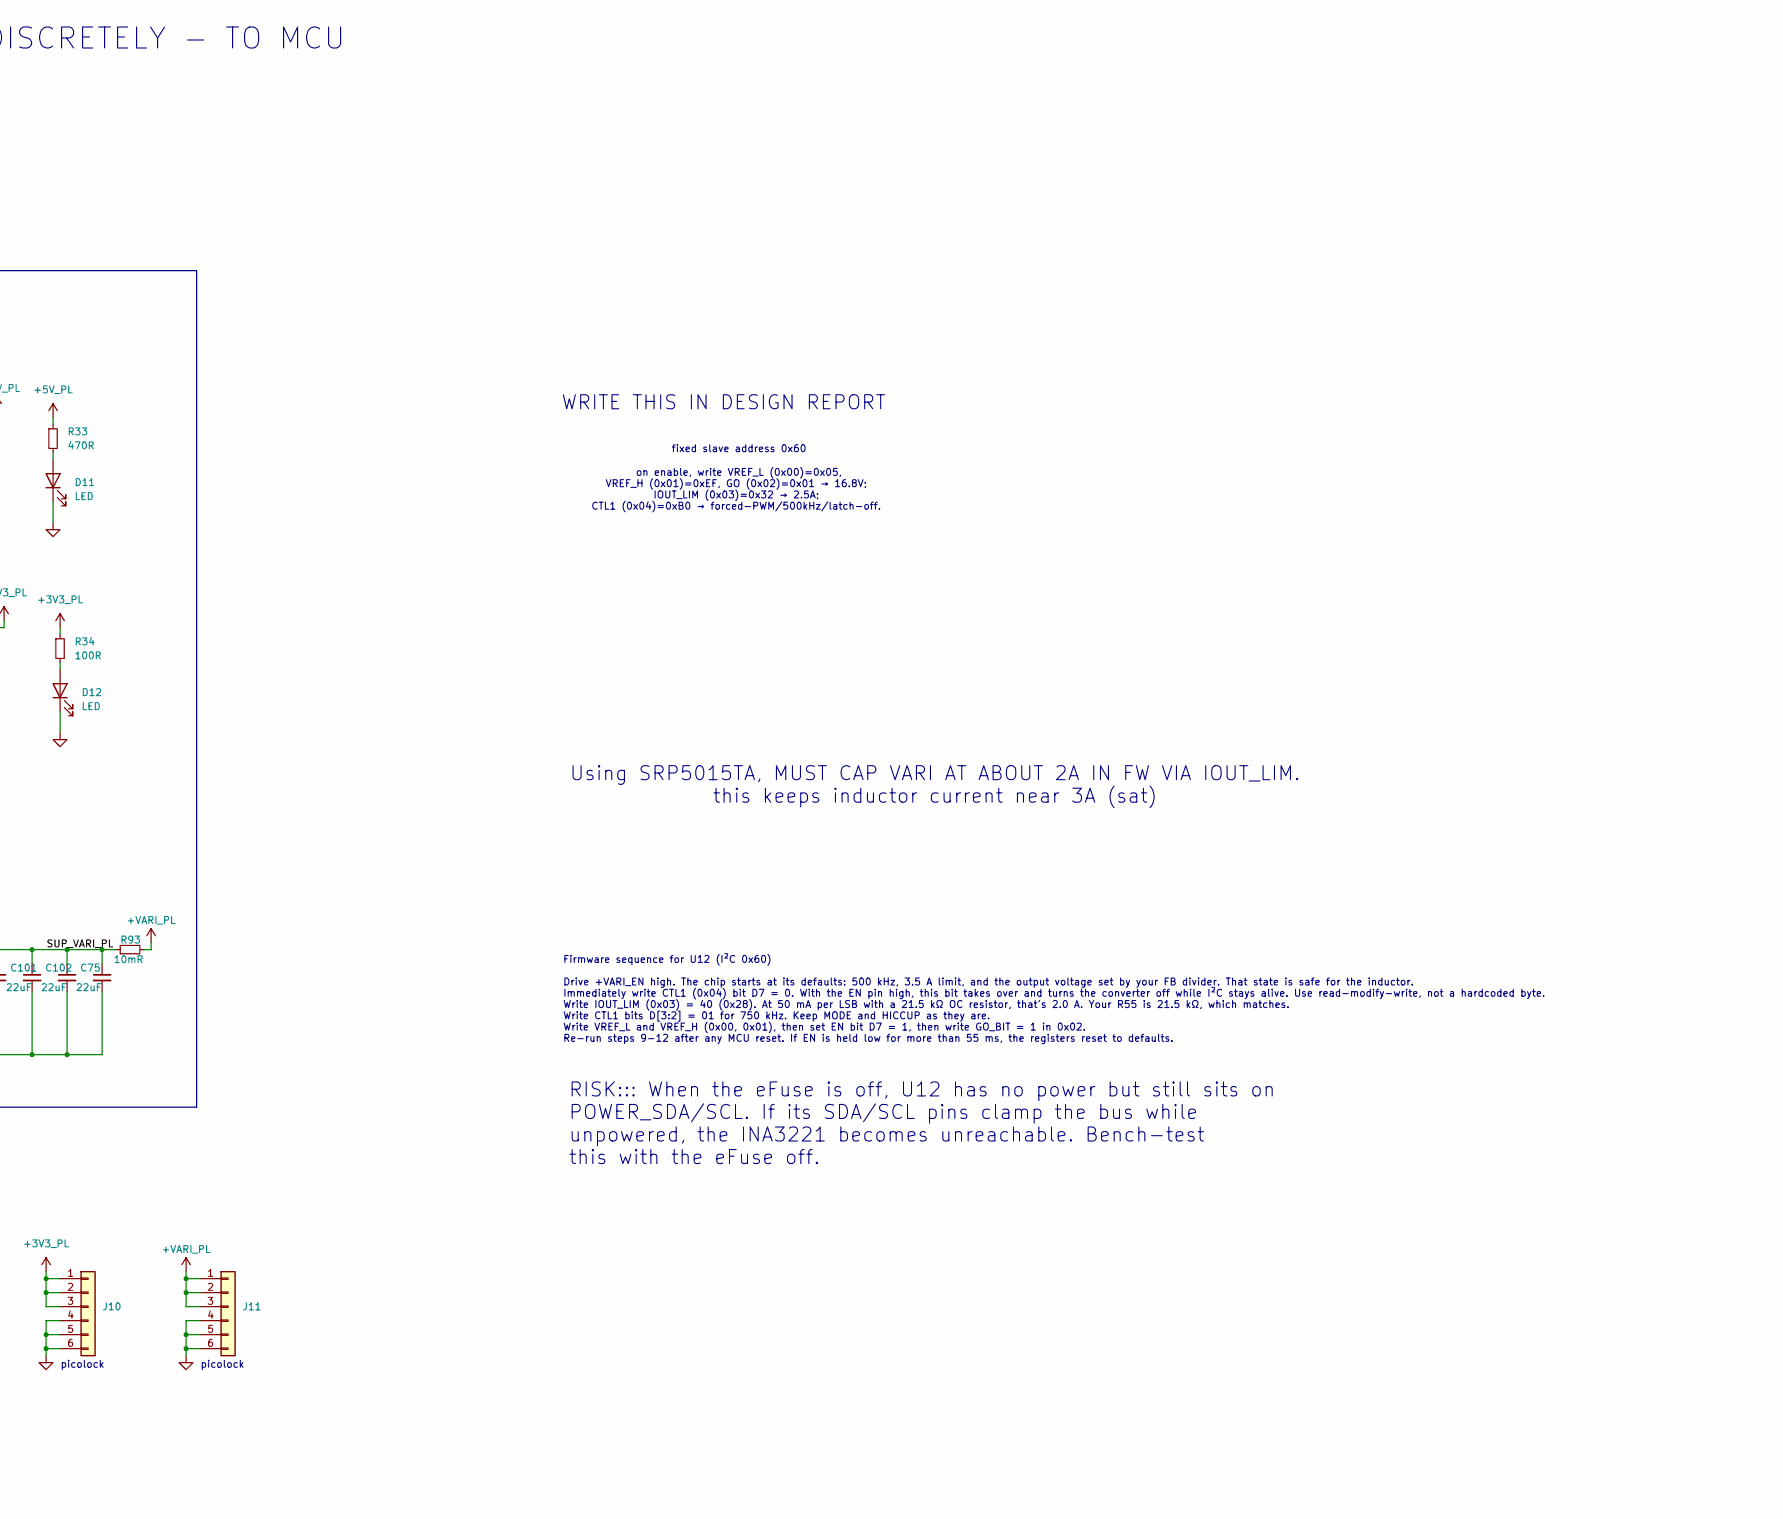
[picture p5: schematic POWER.kicad_sch, part in row 1, column 2]

Parts:
C28, C29, C30, C31, C32, C33, C49, C50, C51, C52: 10uF; C_0603_1608Metric; MPN GRT188R61E106ME13D
C34, C35, C36, C40, C41, C42, C53, C54, C57, C58, C70, C73, C74, C83, C84, C85, C86, C87, C88, C109, C110: 0.1uF; C_0603_1608Metric; MPN GCM188R71H104KA57D
C37, C39: 33nF; C_0603_1608Metric; MPN AC0603KRX7R9BB333
C38, C55, C56, C65, C66, C67: 10nF; C_0603_1608Metric; MPN GCM188R71H103KA37J
C43, C44, C45, C46, C47, C48, C59, C60, C61, C62: 22uF; C_0603_1608Metric; MPN GRT188R61A226ME13D
C68, C69, C75, C76, C77, C101, C102: 22uF; C_0805_2012Metric; MPN GRM21BR61E226ME44L
C71: 22nF; C_0603_1608Metric; MPN GCM188R71H223KA37J
C72: 1uF; C_0603_1608Metric; MPN GCM188R71E105KA64J
D9, D10, D11, D12: LED; LED_0603_1608Metric; MPN 150060GS75000
J9, J10, J11: Conn_01x06; Molex_Pico-Lock_504050-0691_1x06-1MP_P1.50mm_Horizontal; MPN 5040500691
L1, L2, L3, L4, L5, L6: 2.2uF; SRP5015TA-2R2M; MPN SRP5015TA-2R2M
R9, R10, R22, R23, R24, R35, R36, R57, R58, R74, R75, R76, R77, R78, R128, R129, R130, R131, R132, R133, R134, R135, R136, R137: 0R; R_0603_1608Metric; MPN ERJ-3GEY0R00V
R25, R37: 52.3kR; R_0603_1608Metric; MPN ERJ-3EKF5232V
R26, R28, R30, R38, R40: 10kR; R_0603_1608Metric; MPN ERJ-3EKF1002V
R27, R39: 31.6kR; R_0603_1608Metric; MPN ERJ-3EKF3162V
R29: 4.99kR; R_0603_1608Metric; MPN ERJ-3EKF4991V
R31, R33: 470R; R_0603_1608Metric; MPN ERJ-3EKF4700V
R32, R34: 100R; R_0603_1608Metric; MPN ERJ-3EKF1000V
R45, R47, R49: 470kR; R_0603_1608Metric; MPN ERJ-3EKF4703V
R46, R48, R50, R71, R72, R73: 100kR; R_0603_1608Metric; MPN ERJ-3EKF1003V
R53: 430kR; R_0603_1608Metric; MPN ERJ-3EKF4303V
R54: 400kR; R_0603_1608Metric; MPN ERJ-3EKF4023V
R55: 21.5kR; R_0603_1608Metric; MPN ERJ-3EKF2152V
R56: 43.2kR; R_0603_1608Metric; MPN ERJ-3EKF4322V
R89, R94, R95, R96, R97, R98: 10R; R_0603_1608Metric
R91, R92, R93: 10mR; R_0603_1608Metric; MPN WSLP2512R0100DEA
U6, U7, U8, U9, U10: TPS62933; SOT-583-8; MPN TPS62933DRLR
U12: MP28167GQ-A-P; MPN MP28167GQ-A-P
U16: INA3221; Texas_RGV0016A_VQFN-16-1EP_4x4mm_P0.65mm_EP2.1x2.1mm

Connections:
+1V2_HK: C45.2, C48.1, C85.1, L3.2, R29.1; also elsewhere on the board
+3V3_HK: C44.1, C47.1, C84.1, L2.2, R27.1, R32.1; also elsewhere on the board
+3V3_MCU: C109.1, C110.1, U16.4 (VS), U16.16 (VPU); also elsewhere on the board
+3V3_PL: J10.1, J10.2, J10.3, R34.1, R92.2, R96.1
+5V_HK: C43.1, C46.1, C83.1, L1.2, R25.1, R31.1; also elsewhere on the board
+5V_PL: J9.1, J9.2, J9.3, R33.1, R91.2, R94.1
+12V_HK: R57.1, R58.1, R128.1, R129.1, R130.1, R131.1; also elsewhere on the board
+12V_PL: R132.1, R133.1, R134.1, R135.1, R136.1, R137.1; also elsewhere on the board
+VARI_PL: J11.1, J11.2, J11.3, R93.2, R98.1
/+3V3_EN: R71.1, U10.2 (EN); also elsewhere on the board
/+5V_EN: R72.1, U9.2 (EN); also elsewhere on the board
/+VARI_ALT: U12.4 (ALT); also elsewhere on the board
/+VARI_EN: R73.1, U12.3 (EN); also elsewhere on the board
/POWER/SUP_3V3_PL: C60.1, C62.1, C87.1, L5.2, R39.1, R92.1, R95.1
/POWER/SUP_5V_PL: C59.1, C61.1, C86.1, L4.2, R37.1, R89.1, R91.1
/POWER/SUP_VARI_PL: C75.1, C76.1, C77.1, C88.1, C101.1, C102.1, R53.2, R93.1, R97.1, U12.12 (OUT)
/POWER_SCL: U12.5 (SCL), U16.6 (SCL); also elsewhere on the board
/POWER_SDA: U12.6 (SDA), U16.7 (SDA); also elsewhere on the board
GND: C28.2, C29.2, C30.2, C31.2, C32.2, C33.2, C34.2, C35.2, C36.2, C37.2, C38.2, C39.2, C43.2, C44.2, C45.1, C46.2, C47.2, C48.2, C49.2, C50.2, C51.2, C52.2, C53.2, C54.2, C55.2, C56.2, C59.2, C60.2, C61.2, C62.2, C65.2, C66.2, C67.2, C68.2, C69.2, C70.2, C71.2, C72.2, C75.2, C76.2, C77.2, C83.2, C84.2, C85.2, C86.2, C87.2, C88.2, C101.2, C102.2, C109.2, C110.2, D9.1 (K), D10.1 (K), D11.1 (K), D12.1 (K), J9.4, J9.5, J9.6, J10.4, J10.5, J10.6, J11.4, J11.5, J11.6, R22.2, R23.2, R24.2, R26.2, R28.2, R30.2, R35.2, R36.2, R38.2, R40.2, R46.2, R48.2, R50.2, R55.2, R56.1, R71.2, R72.2, R73.2, U6.4 (GND), U7.4 (GND), U8.4 (GND), U9.4 (GND), U10.4 (GND), U12.2 (GND), U12.10 (AGND), U12.11 (GND), U16.3 (GND), U16.5 (A0), U16.17 (EP); also elsewhere on the board
unnamed: C40.2, R76.2
unnamed: C41.2, R75.2
unnamed: C42.1, R74.2
unnamed: C57.2, R77.2
unnamed: C58.2, R78.2
unnamed: C73.1, R9.2
unnamed: C74.1, R10.2
unnamed: D9.2 (A), R31.2
unnamed: D10.2 (A), R32.2
unnamed: D11.2 (A), R33.2
unnamed: D12.2 (A), R34.2
unnamed: R53.1, R54.2, R56.2
unnamed: R76.1, U6.6 (BST)
unnamed: C65.1, R45.2, R46.1, U6.2 (EN)
unnamed: R25.2, R26.1, U6.8 (FB)
unnamed: R22.1, U6.1 (RT)
unnamed: C37.1, U6.7 (SS)
unnamed: C40.1, L1.1, U6.5 (SW)
unnamed: C28.1, C31.1, C34.1, R45.1, R57.2, R58.2, U6.3 (VIN)
unnamed: R75.1, U7.6 (BST)
unnamed: C66.1, R47.2, R48.1, U7.2 (EN)
unnamed: R27.2, R28.1, U7.8 (FB)
unnamed: R23.1, U7.1 (RT)
unnamed: C38.1, U7.7 (SS)
unnamed: C41.1, L2.1, U7.5 (SW)
unnamed: C29.1, C32.1, C35.1, R47.1, R128.2, R129.2, U7.3 (VIN)
unnamed: R74.1, U8.6 (BST)
unnamed: C67.1, R49.2, R50.1, U8.2 (EN)
unnamed: R29.2, R30.1, U8.8 (FB)
unnamed: R24.1, U8.1 (RT)
unnamed: C39.1, U8.7 (SS)
unnamed: C42.2, L3.1, U8.5 (SW)
unnamed: C30.1, C33.1, C36.1, R49.1, R130.2, R131.2, U8.3 (VIN)
unnamed: R77.1, U9.6 (BST)
unnamed: R37.2, R38.1, U9.8 (FB)
unnamed: R35.1, U9.1 (RT)
unnamed: C55.1, U9.7 (SS)
unnamed: C57.1, L4.1, U9.5 (SW)
unnamed: C49.1, C51.1, C53.1, R132.2, R133.2, U9.3 (VIN)
unnamed: R78.1, U10.6 (BST)
unnamed: R39.2, R40.1, U10.8 (FB)
unnamed: R36.1, U10.1 (RT)
unnamed: C56.1, U10.7 (SS)
unnamed: C58.1, L5.1, U10.5 (SW)
unnamed: C50.1, C52.1, C54.1, R134.2, R135.2, U10.3 (VIN)
unnamed: R9.1, U12.16 (BST1)
unnamed: R10.1, U12.13 (BST2)
unnamed: R54.1, U12.8 (FB)
unnamed: C68.1, C69.1, C70.1, R136.2, R137.2, U12.1 (IN)
unnamed: C71.1, R55.1, U12.7 (OC)
unnamed: C73.2, L6.1, U12.15 (SW1)
unnamed: C74.2, L6.2, U12.14 (SW2)
unnamed: C72.1, U12.9 (VCC)
unnamed: R89.2, U16.12 (IN+1)
unnamed: R95.2, U16.15 (IN+2)
unnamed: R97.2, U16.2 (IN+3)
unnamed: R94.2, U16.11 (IN-1)
unnamed: R96.2, U16.14 (IN-2)
unnamed: R98.2, U16.1 (IN-3)

Notes on the sheet:
Firmware sequence for U12 (I²C 0x60) Drive +VARI_EN high. The chip starts at its defaults: 500 kHz, 3.5 A limit, and the output voltage set by your FB divider. That state is safe for the inductor. Immediately write CTL1 (0x04) bit D7 = 0. With the EN pin high, this bit takes over and turns the conv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
WRITE THIS IN DESIGN REPORT
HK POWER
Tie A0 → GND for address 0x40
picolock
on enable, write VREF_L (0x00)=0x05, VREF_H (0x01)=0xEF, GO (0x02)=0x01 → 16.8V; IOUT_LIM (0x03)=0x32 → 2.5A; CTL1 (0x04)=0xB0 → forced-PWM/500kHz/latch-off.
PAYLOAD POWER
MP28167 is at 0x60
NEED TO ADD PG INDICATORS ON THESE RAILS DISCRETELY - TO MCU
Using SRP5015TA, MUST CAP VARI AT ABOUT 2A IN FW VIA IOUT_LIM. this keeps inductor current near 3A (sat)
402 FOR DEV !!
fixed slave address 0x60
RISK::: When the eFuse is off, U12 has no power but still sits on POWER_SDA/SCL. If its SDA/SCL pins clamp the bus while unpowered, the INA3221 becomes unreachable. Bench-test this with the eFuse off.

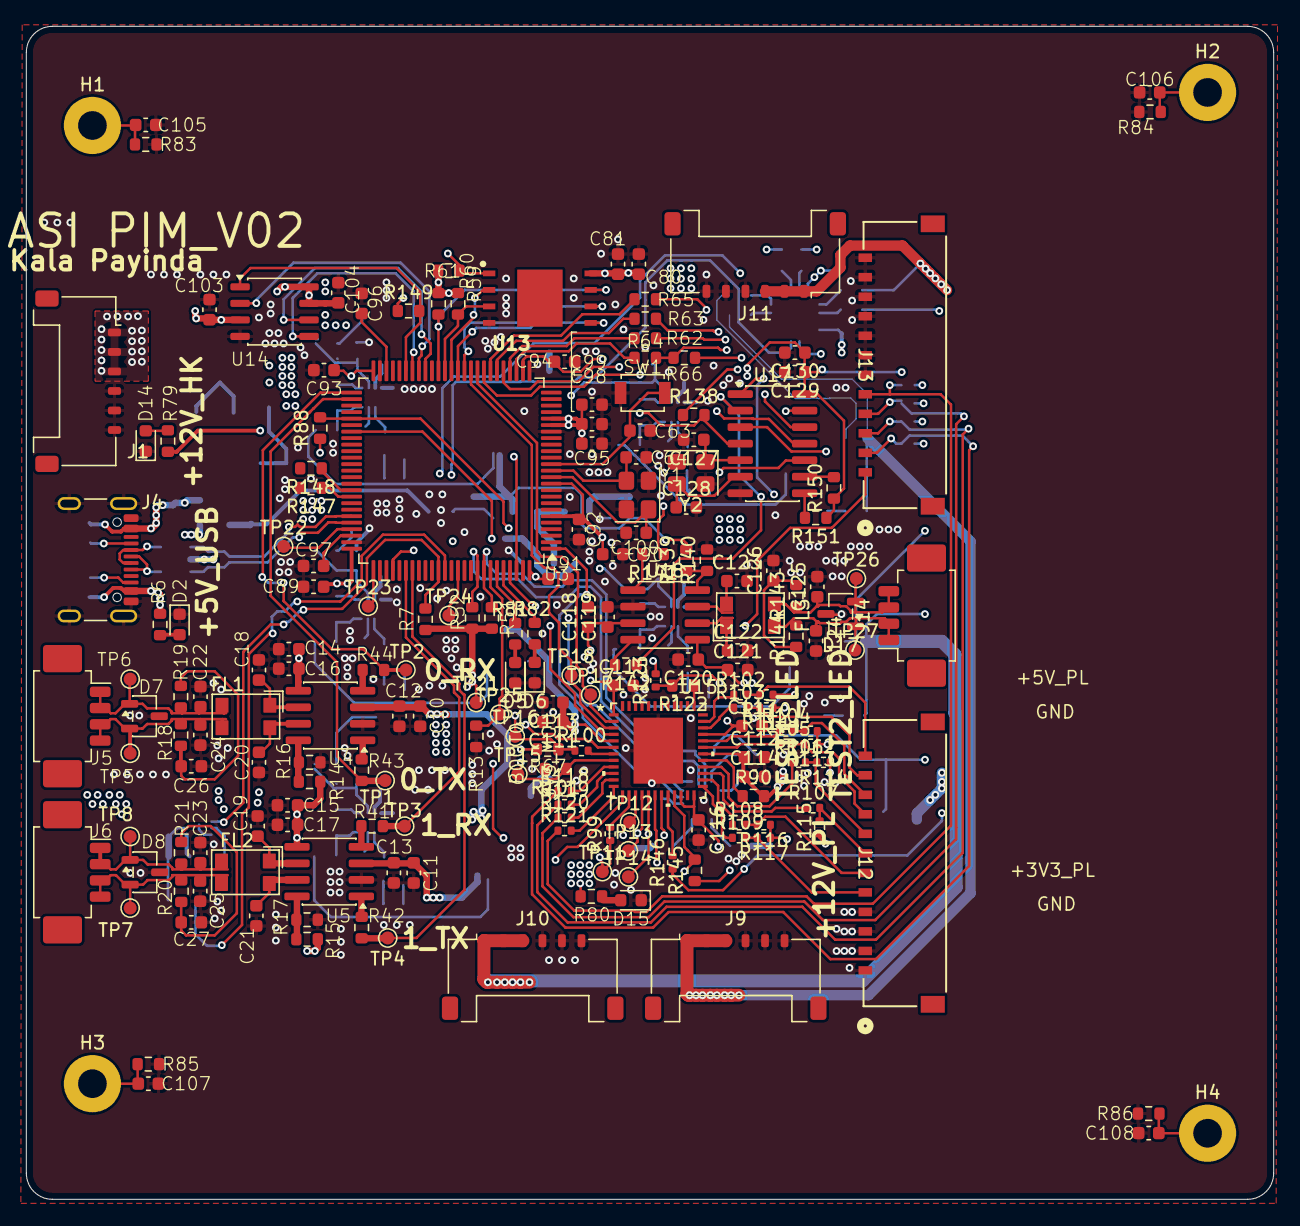
[picture p6: board PIM_V02.kicad_pcb from above]

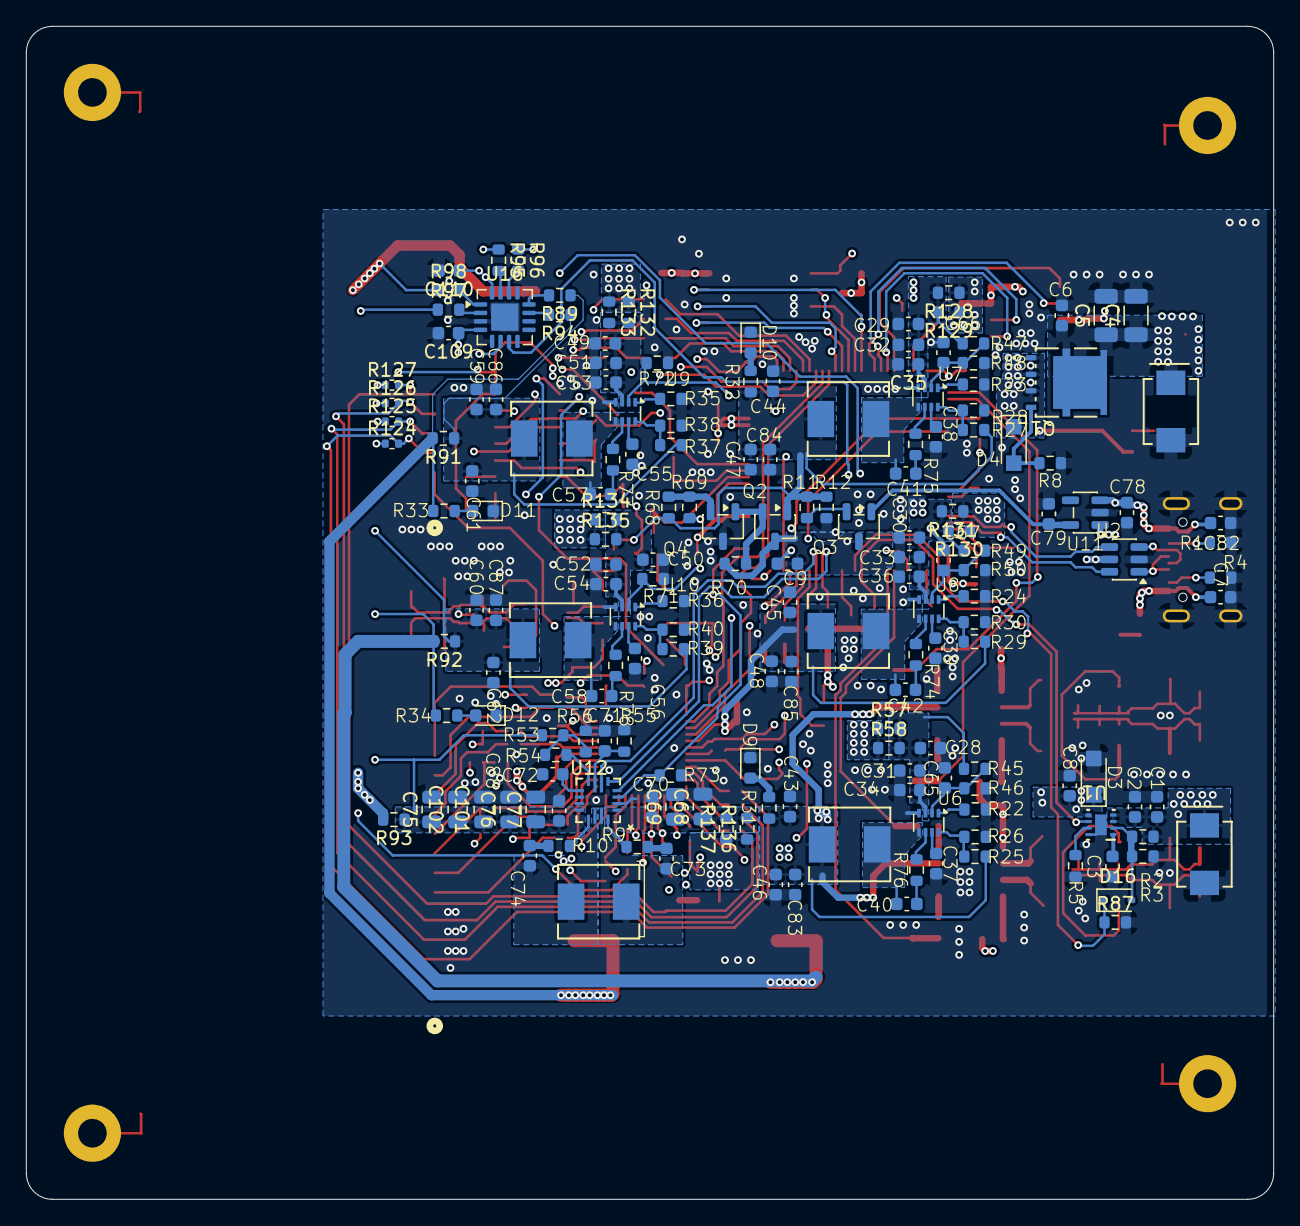
[picture p7: board PIM_V02.kicad_pcb from below]

Board: 4 copper layers, 95.9 x 90.2 mm, 369 parts (175 on the bottom side), 211 nets.
