kpayinda/PIM_V02/(commit log)

2026-09-08 initial commit, copied from V01
    [CAN.kicad_sch, MAIN.kicad_sch, PIM_V02.kicad_pcb, POWER.kicad_sch]
2026-09-24 more changes, near final schematic and part way through layout now
    [CAN.kicad_sch, MAIN.kicad_sch, PIM_V02.kicad_pcb, PIM_V02.kicad_sch, POWER.kicad_sch]
2026-09-27 pc104 outline, nearly done with layout, managed to keep it at 4 layers but the traces became quite messy; still need to do an in depth review to ensure i havent cut across any zones unknowingly; also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
    [CAN.kicad_sch, PIM_V02.kicad_pcb, PIM_V02.kicad_sch, POWER.kicad_sch]
2026-09-28 No errors, just need to clean up the silkscreen. ready for a review
    [PIM_V02.kicad_pcb, PIM_V02.kicad_sch]
